urs8000/LoRa-Gateway-Locator_UNO/6-all_assembled.jpg

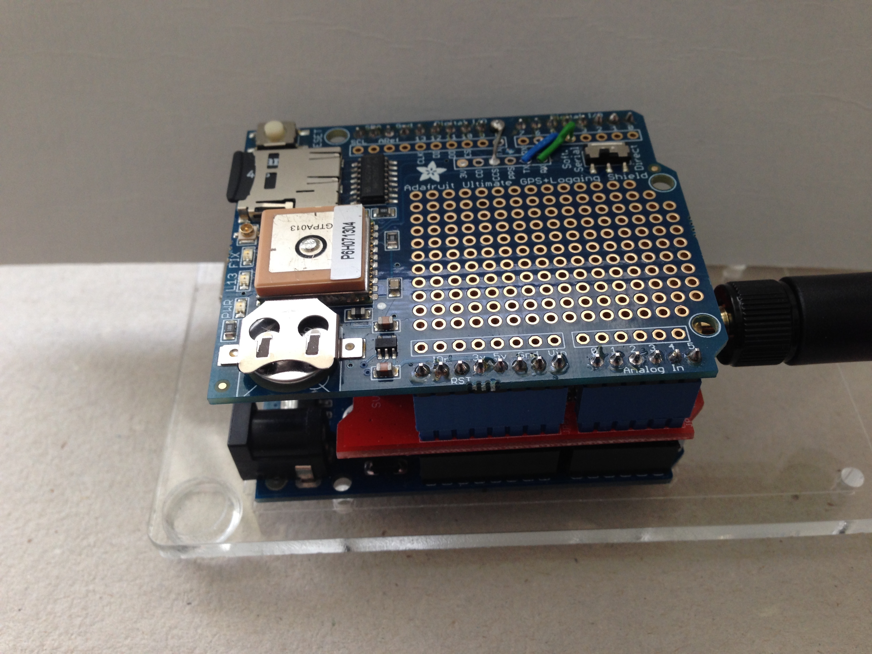
6-all_assembled.jpg
