urs8000/LoRa-Gateway-Locator_UNO/7-all_assembled-2.jpg

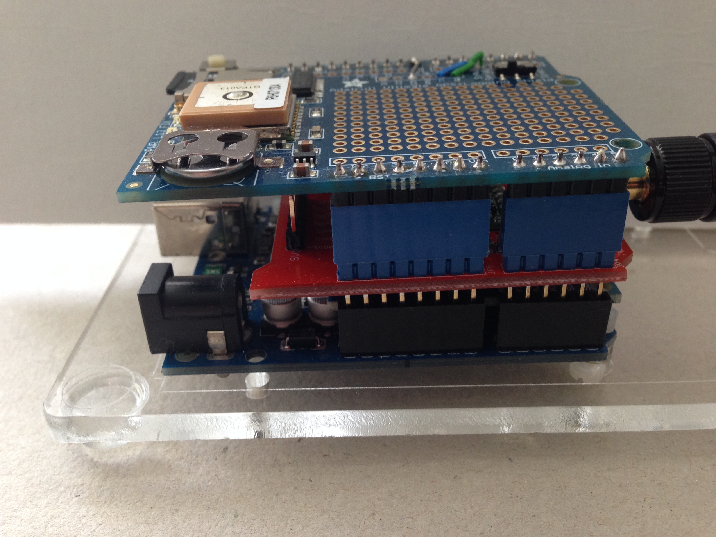
7-all_assembled-2.jpg
