urs8000/LoRa-Gateway-Locator_UNO/1-UNO.JPG

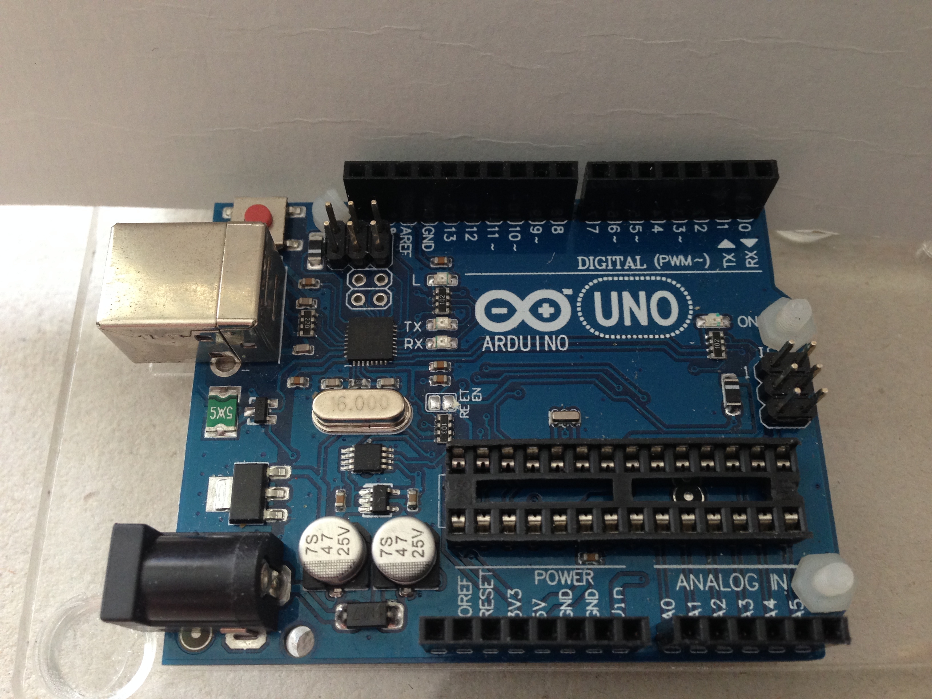
1-UNO.JPG
