urs8000/LoRa-Gateway-Locator_UNO/2-piggy pack board.jpg

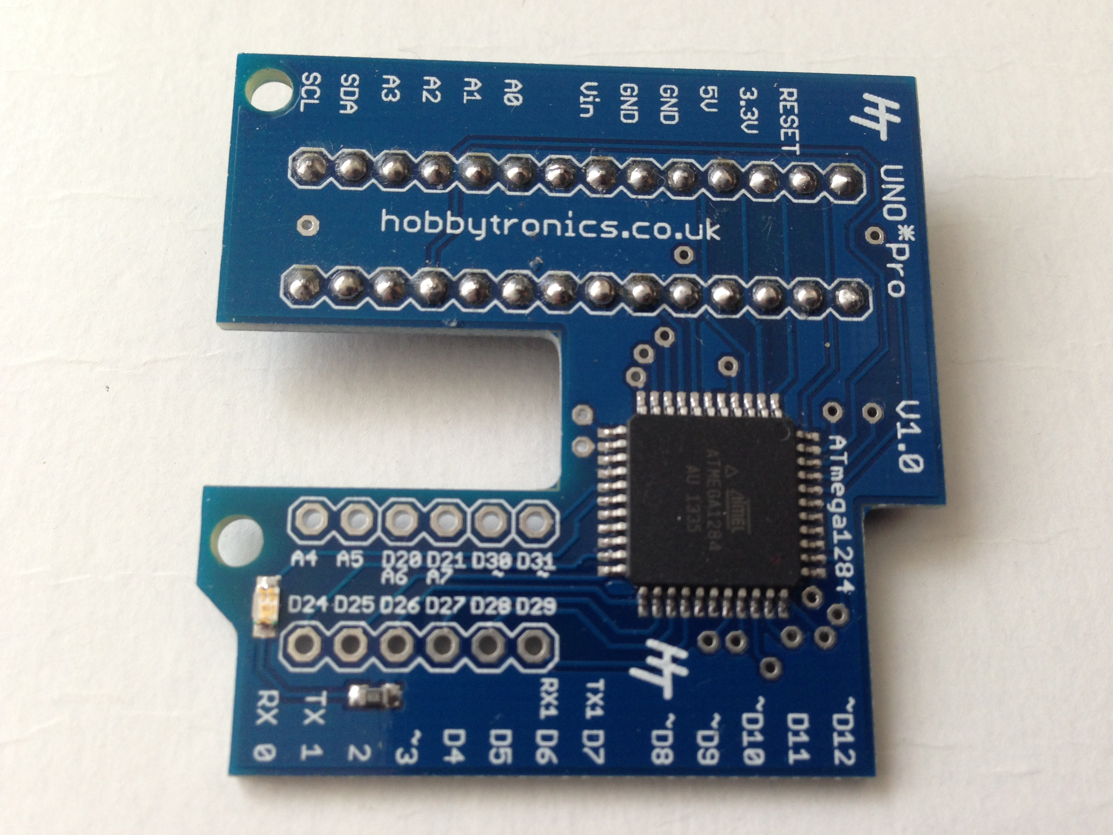
2-piggy pack board.jpg
