urs8000/LoRa-Gateway-Locator_UNO/3-UNO-1284.jpg

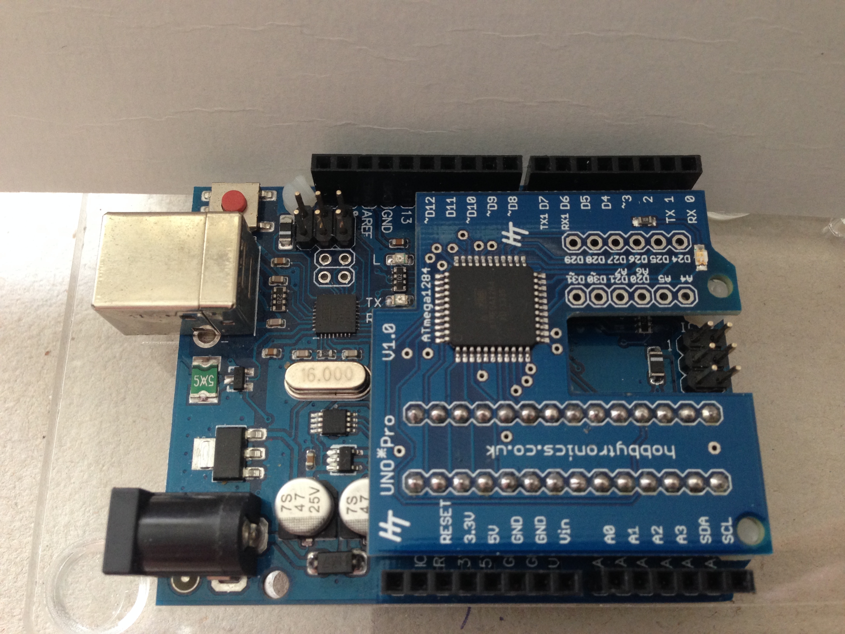
3-UNO-1284.jpg
