urs8000/LoRa-Gateway-Locator_UNO/4-with_Dragino.jpg

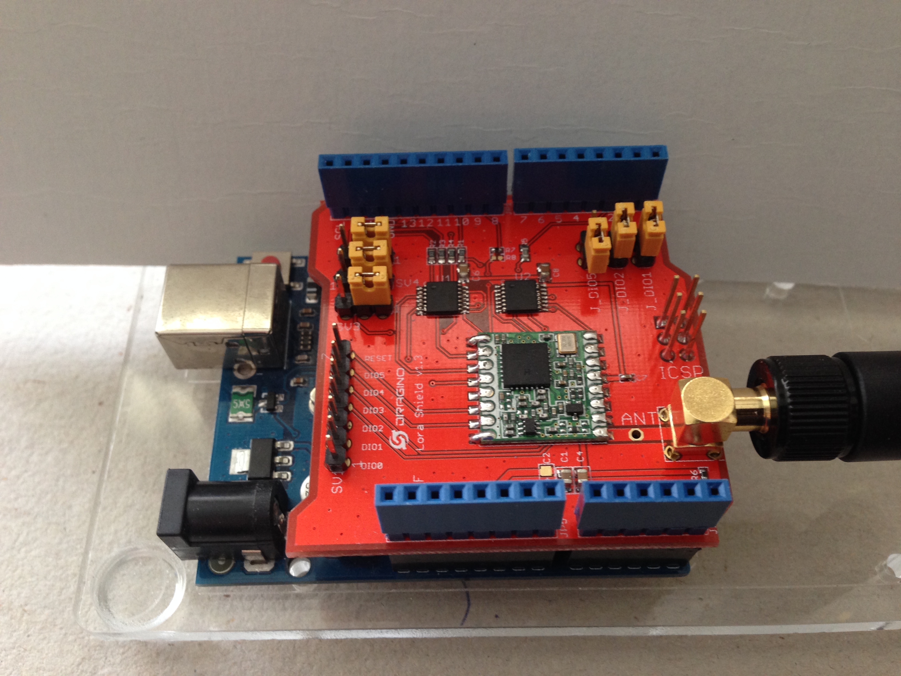
4-with_Dragino.jpg
