urs8000/LoRa-Gateway-Locator_UNO/5-modified_GPS_shield.jpg

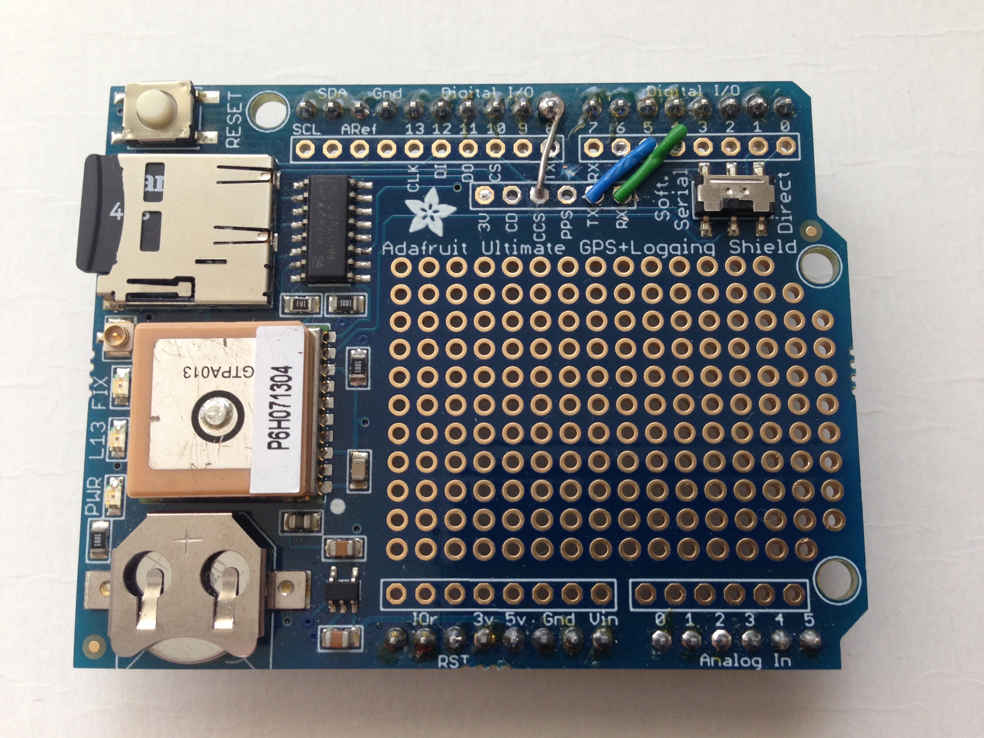
5-modified_GPS_shield.jpg
