urs8000/LoRa-Gateway-Locator_UNO/Mod_1.jpg

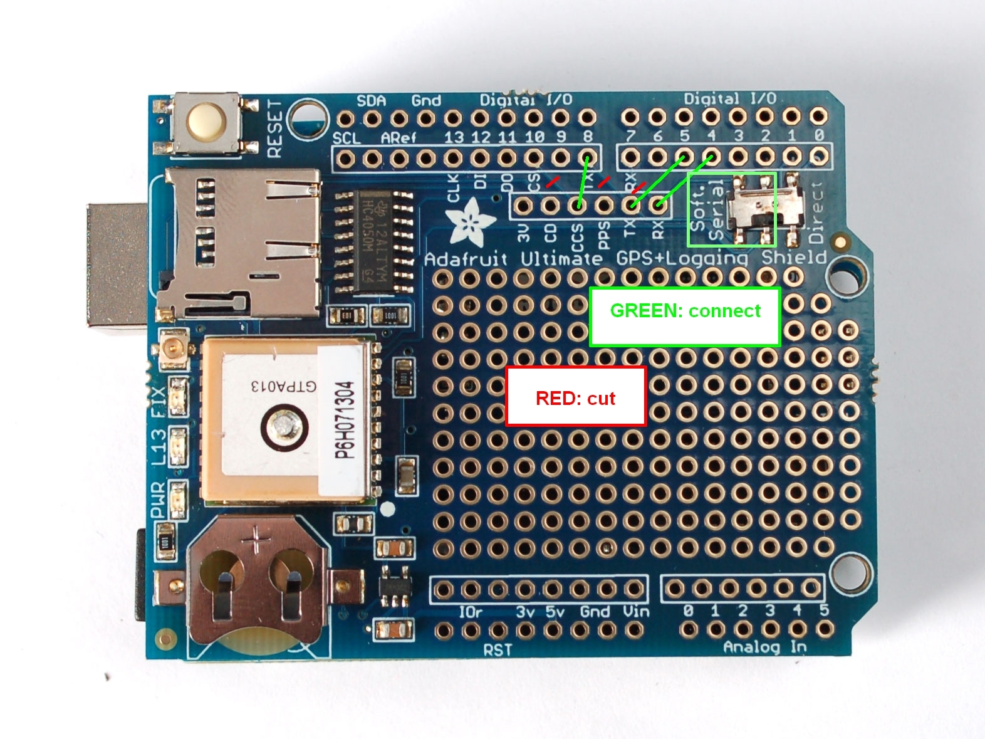
Mod_1.jpg
